RetroSwimAU/PicoX68Key/README.md

# PicoX68Key
An X68000 USB keyboard adaptor for 2025

See PicoX68Key.c for more information.
