RetroSwimAU/PicoX68Key/include/layout_us.h

/**
 * Keyboard layout info moved from the original main file since we are now catering for 2 or more 
 * different layouts. For original info and attribution please see the header in main.cpp
 * @file layout_us.h
 * @author Martin White (you@domain.com) RetroSwim (retro@retroswim.net)
 * @brief Keyboard layout info.
 * @version 0.2
 */

#ifndef _LAYOUT_H_INCLUDED
#define _LAYOUT_H_INCLUDED

// Silence IDE without needing to include files
typedef unsigned char uint8_t;

#define CTRL_SCAN 0x71
#define SHIFT_SCAN 0x70
#define HIRA_SCAN 0x56
#define WIDTH_SCAN 0x60
#define OPT1_SCAN 0x72
#define OPT2_SCAN 0x73

// Untested, but should work the same as the original code.
//
// Added modifier keys here to simplify design of main logic.
//
// TODO: Work on the key remaps so they match the printed symbols on the keyboard
// KEY CODE TO X68K---- -0-----1-----2-----3-----4-----5-----6-----7-----8-----9-----A-----B-----C-----D-----E-----F--
uint8_t keymapping[] = {0x00, 0x00, 0x00, 0x00, 0x1E, 0x2E, 0x2C, 0x20, 0x13, 0x21, 0x22, 0x23, 0x18, 0x24, 0x25, 0x26,	 // 0x
						0x30, 0x2F, 0x19, 0x1A, 0x11, 0x14, 0x1F, 0x15, 0x17, 0x2D, 0x12, 0x2B, 0x16, 0x2A, 0x02, 0x03,	 // 1x
						0x04, 0x05, 0x06, 0x07, 0x08, 0x09, 0x0A, 0x0B, 0x1D, 0x01, 0x0F, 0x10, 0x35, 0x0D, 0x0C, 0x1C,	 // 2x
						0x29, 0x0E, 0x00, 0x27, 0x28, 0x5F, 0x31, 0x32, 0x33, 0x5D, 0x63, 0x64, 0x65, 0x66, 0x67, 0x68,	 // 3x
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
// Note that arrays must be the same size
uint8_t altKeysUSB[] = {0x54, 0x55, 0x56, 0x3A, 0x3B, 0x3C, 0x3D, 0x3E};
uint8_t altKeyCodes[] = {0x52, 0x53, 0x54, 0x55, 0x56, 0x57, 0x58, 0x59};

#endif
