RetroSwimAU/PicoX68Key/(commit log)

2025-11-12 Oops, missed some Pico project files
2025-11-13 Start PCB layout
    [PicoX68Key.kicad_pcb, PicoX68Key.kicad_sch]
2025-11-13 Fix KiCad directory structure
    [PicoX68Key.kicad_pcb, PicoX68Key.kicad_sch]
2025-11-15 Begin work PCB layout
    [PicoX68Key.kicad_pcb]
2025-11-15 Embed 3D model, fix path
    [PicoX68Key.kicad_pcb]
2025-11-16 Add mini-din7 connector, finish routing
    [PicoX68Key.kicad_pcb, PicoX68Key.kicad_sch]
2025-11-17 Layout tidy up, add flood planes
    [PicoX68Key.kicad_pcb, PicoX68Key.kicad_sch]
2025-11-17 New Pico footprint, change pin header to be SPI for future LED board
    [PicoX68Key.kicad_pcb, PicoX68Key.kicad_sch]
2025-11-17 Got keyboard LEDs working
    [PicoX68Key.kicad_pcb]
2025-11-17 Reflowed flood fills, first version sent to manufacture!
    [PicoX68Key-B_Cu.gbr, PicoX68Key-B_Mask.gbr, PicoX68Key-B_Paste.gbr, PicoX68Key-B_Silkscreen.gbr, PicoX68Key-Edge_Cuts.gbr, PicoX68Key-F_Cu.gbr, PicoX68Key-F_Mask.gbr, PicoX68Key-F_Paste.gbr]
2025-11-19 Fix DIN footprint, board cleanup, silkscreen shenanigans
    [PicoX68Key.kicad_pcb, PicoX68Key.kicad_sch]
